Oldfusiondesigns/OFD_Flycore_Angled_Talon/Turbine_Open/Turbine_Mando.PNG

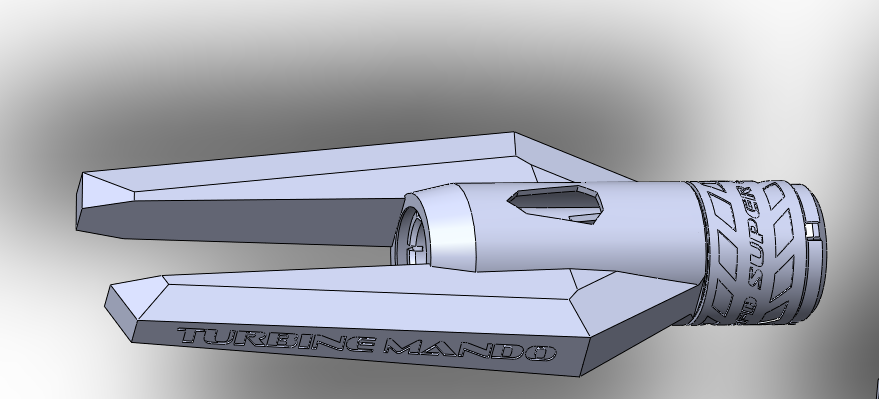
Turbine_Open/Turbine_Mando.PNG
