Oldfusiondesigns/OFD_Flycore_Angled_Talon/README.md

- 👋 Hi, It's Adam - aka OFD (OldFusionDesigns)!
- Please enjoy these files - the Flycore project, an open source Flywheel core for designing new and exciting blasters, as well as open source shroud geometry for my turbine scar!
