Oldfusiondesigns/OFD_Flycore_Angled_Talon/OFD_Flycore_Angled_V1/README.md

**What is Flycore?**

· Flycore is a 90% complete blaster awaiting your
new shell, design, or integration! I’ve done all
the work on flywheel spacing, pusher
mechanisms, and even a complete magwell with
detent or release!

· The goal of Flycore is to allow designers new
and old to focus on creating exciting new
designs with a proven flywheel core that’s
simple to build and has compact geometry to
integrate

**Details**

· Compatible with ANY Flywheel (From FTW to
Banned Blasters)

· Compatible with BOTH Angled and Slim Angled
Talons (Nightingale mags) with the same mag
release/detent

· Takes N20 Pushers (ROF from 300rpm/5dps up
to 3000rpm/50dps)

· Rear pusher position switch for controllable rate
of fire (wiring similar to 3 switch rapidstrike)

· Compatible with any 130 profile motor (can fit
132, 180s)

· Experimental topload capability

· Full steps provided to create your own new and
exciting blasters!

**Licensing and
Production**

· Flycore is license under CC-BY-SA-NC

· You have permission to print as many as you
like for yourself, and remix the files in any way
you like, but you CANNOT sell files or prints
without my permission or coming to an
agreement.

· If you wish to sell, please contact me so we can
arrange a licensing fee for a small percentage of
sale price

**Hardware List**

(2) 130 motors

(1) N20 Pusher Motor of your choice! (300-
3000rpm)

(4) m2x5mm motor screws

(8) M3x6mm heat set inserts (longer ones may
not work)

(6) M2.6x12mm toy screws

(1) M2.6x10mm toy screw (Optional)

(1) Cherry DB2 style switch for pusher position
(Optional)

(1) Spring 20mm in length less than 7mm in
diameter for mag release (Recommend
McMaster 9657K297 Trimmed to 20mm)
