Oldfusiondesigns/OFD_Flycore_Angled_Talon/OFD_Flycore_Angled_V1/OFD_Flycore_Angled_V1.pdf

## OFD

## FLYCORE

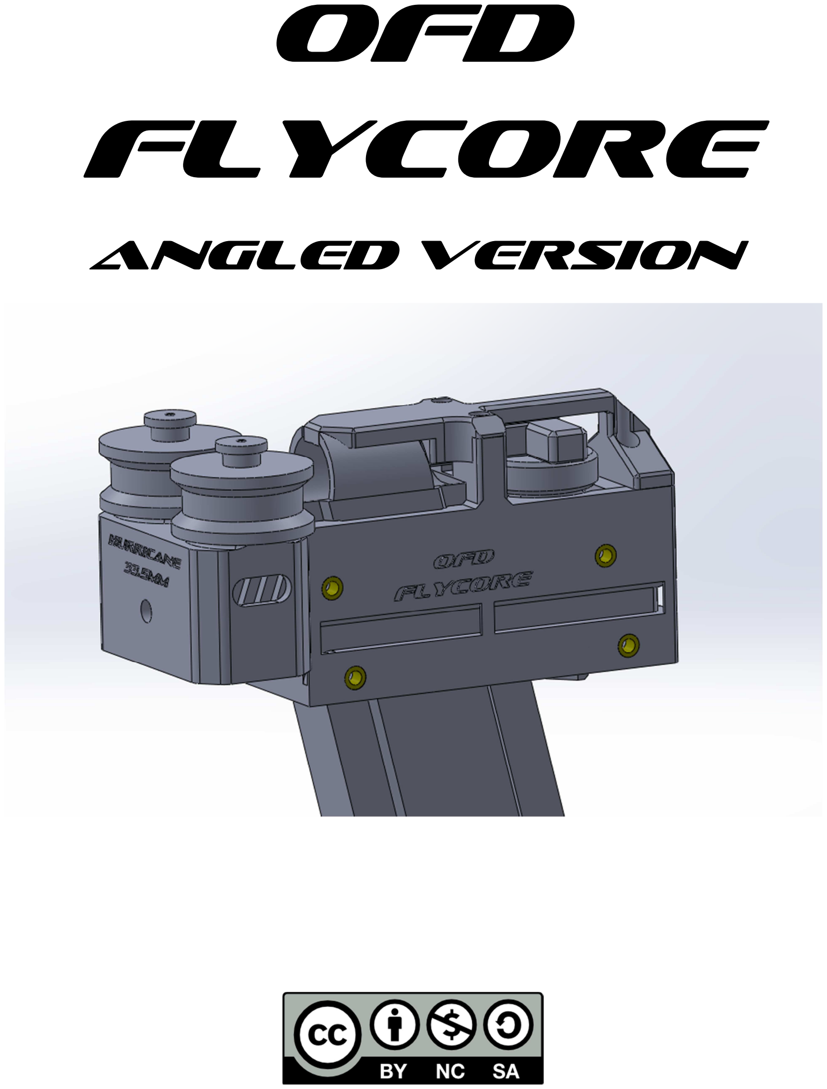
[picture p2: page 1]

Angled Version

What is Flycore?
- Flycore is a 90% complete blaster awaiting your new shell, design, or integration! I’ve done all the work on flywheel spacing, pusher mechanisms, and even a complete magwell with detent or release!
- The goal of Flycore is to allow designers new and old to focus on creating exciting new designs with a proven flywheel core that’s simple to build and has compact geometry to integrate

Details
- Compatible with ANY Flywheel (From FTW to Banned Blasters)
- Compatible with BOTH Angled and Slim Angled Talons (Nightingale mags) with the same mag release/detent
- Takes N20 Pushers (ROF from 300rpm/5dps up to 3000rpm/50dps)

- Rear pusher position switch for controllable rate of fire (wiring similar to 3 switch rapidstrike)
- Compatible with any 130 profile motor (can fit 132, 180s)
- Experimental topload capability
- Full steps provided to create your own new and exciting blasters!

Licensing and
Production
- Flycore is license under CC-BY-SA-NC
- You have permission to print as many as you like for yourself, and remix the files in any way you like, but you CANNOT sell files or prints without my permission or coming to an agreement.
- If you wish to sell, please contact me so we can arrange a licensing fee for a small percentage of sale price

Hardware List
(2) 130 motors
(1) N20 Pusher Motor of your choice! (300-3000rpm)
(4) m2x5mm motor screws
(8) M3x6mm heat set inserts (longer ones may not work)
(6) M2.6x12mm toy screws
(1) M2.6x10mm toy screw (Optional)
(1) Cherry DB2 style switch for pusher position (Optional)
(1) Spring 20mm in length less than 7mm in diameter for mag release (Recommend McMaster 9657K297 Trimmed to 20mm)

Print Orientation
- Supported Pieces (from buildplate): Core, Pusher
- Recommended Print settings (ALL): at least 3 perimeters, 15% infill, PETG Core if you’re using motors that get hot. Brim optional.

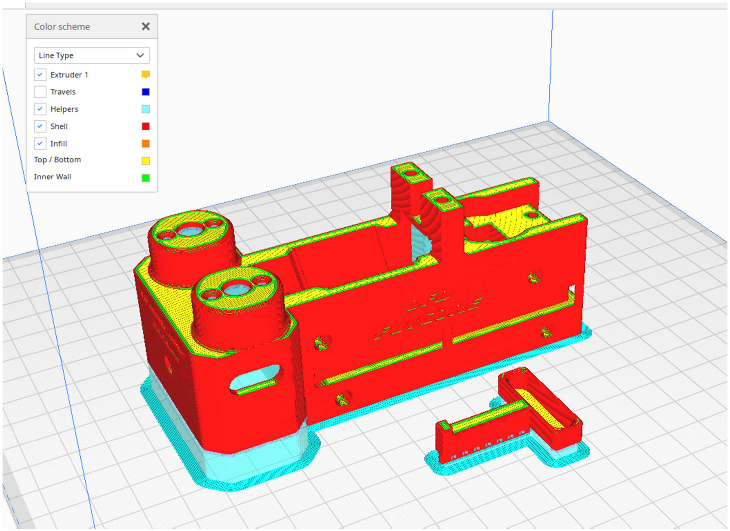
[picture p3: figure]

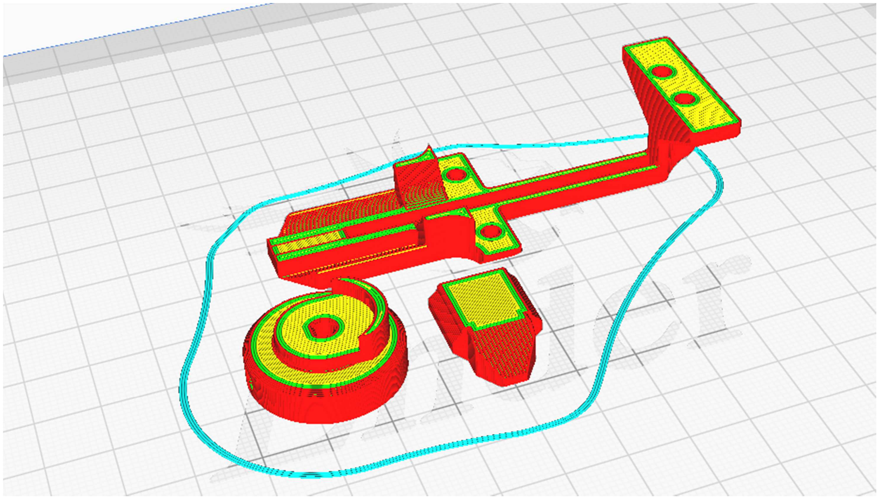
[picture p4: figure]

Assembly
Step 1: Install heatsets
TIP: Trim off any flashing inside and outside the core to prevent installation issues

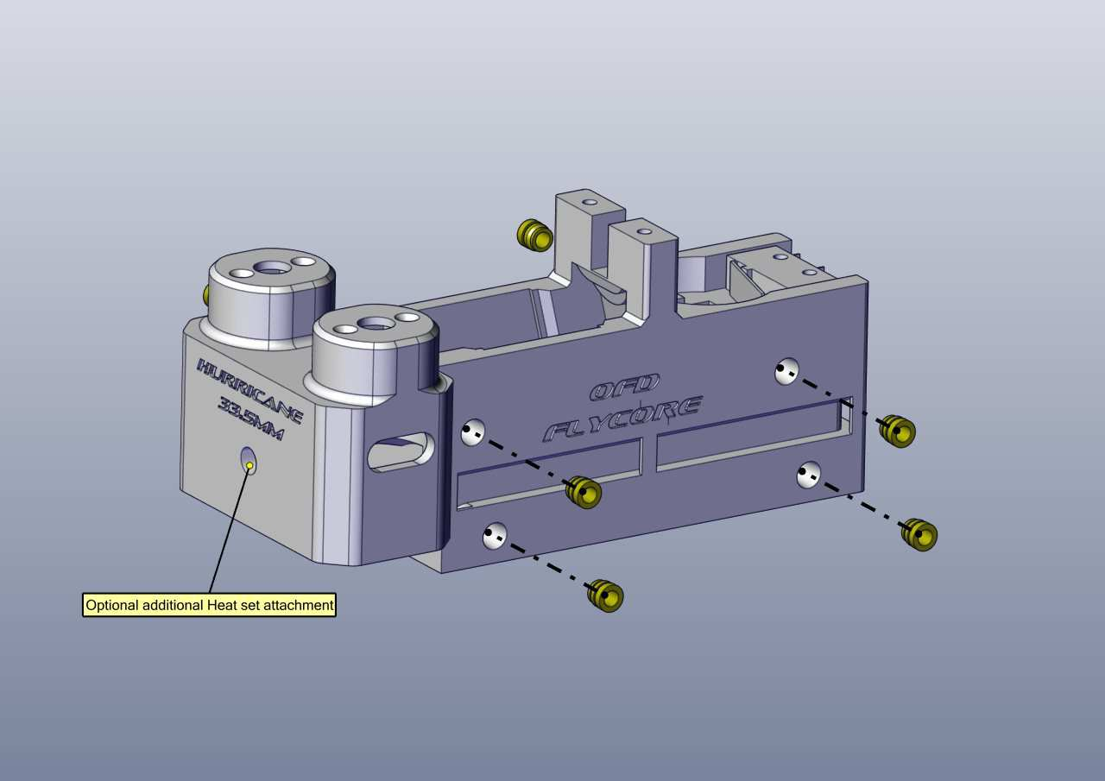
[picture p5: figure]

Step 2: Install N20

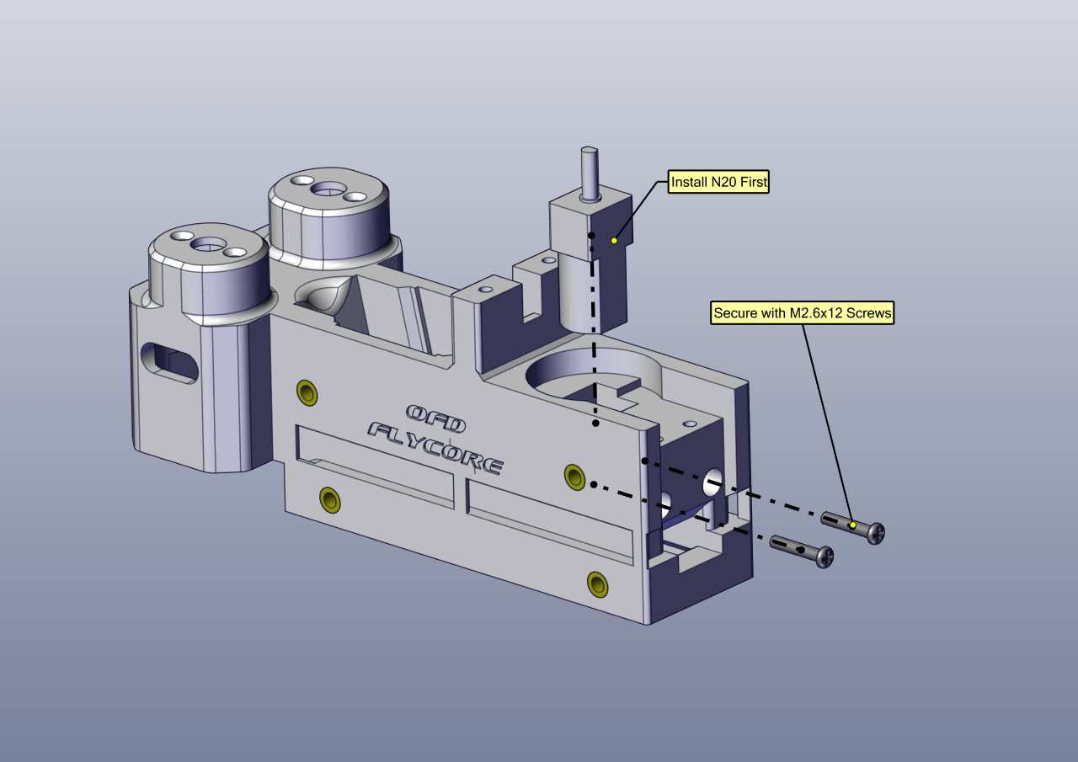
[picture p6: figure]

Step 3: Install Pusher Wheel

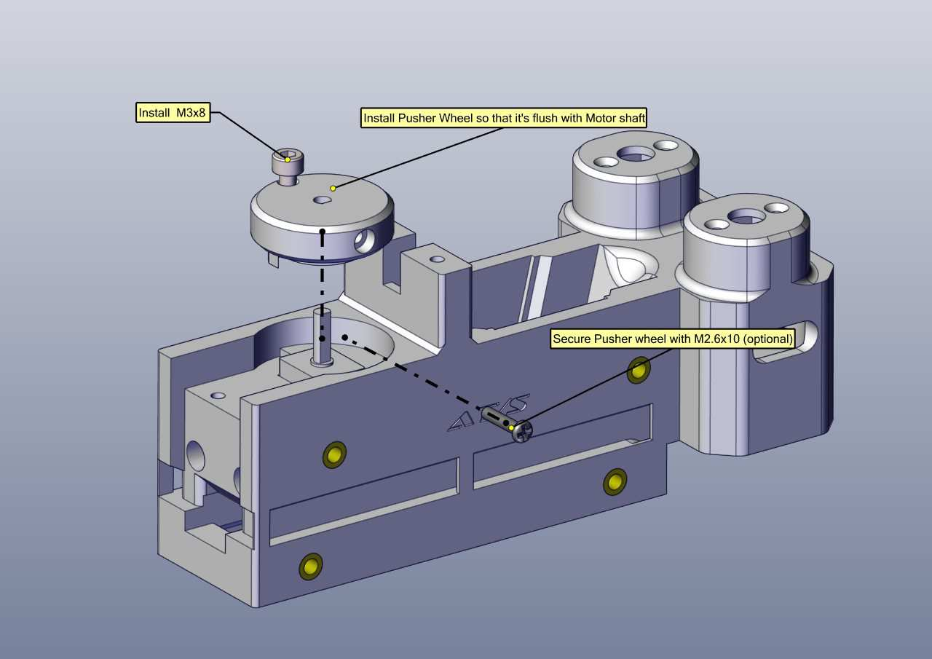
[picture p7: figure]

Step 4: Pusher Assembly Installation

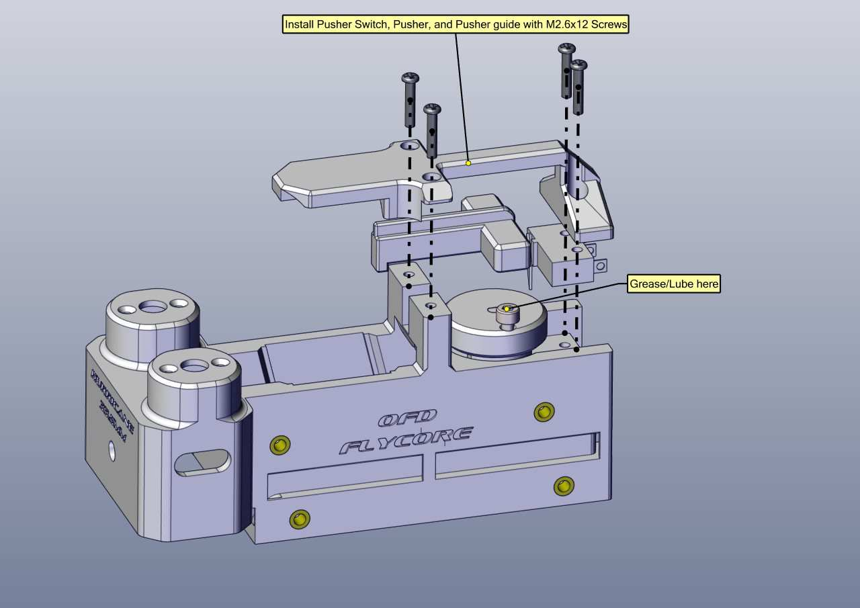
[picture p8: figure]

Step 5: Mag Release Installation

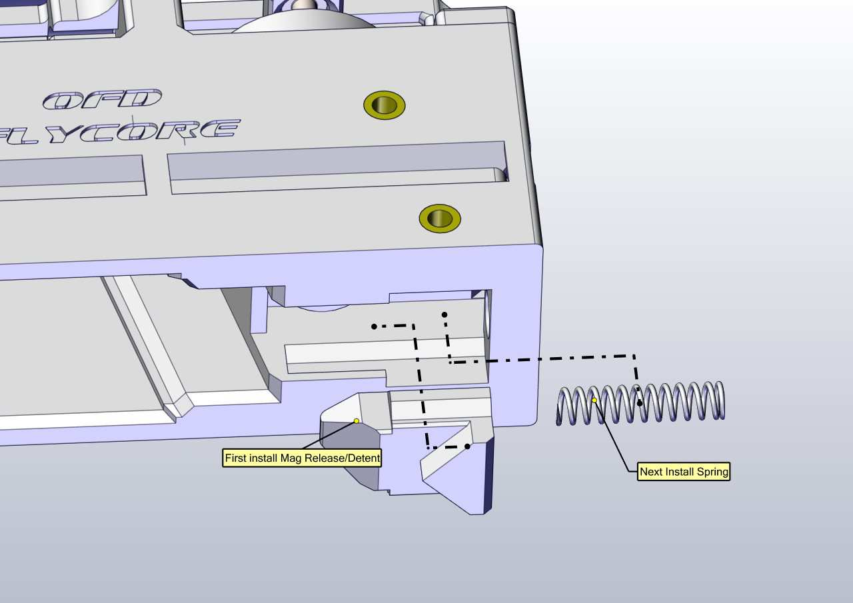
[picture p9: figure]

Step 6: Motor and Flywheel Installation

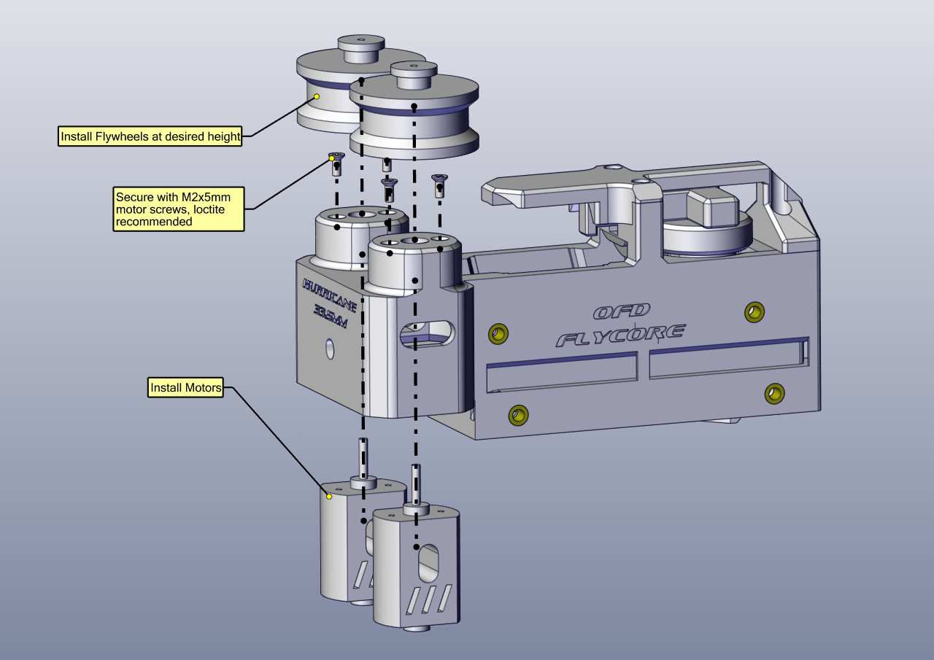
[picture p10: figure]

FAQ
- My N20 doesn’t seem like it’s activating the pusher switch!
a)If this is the case, bend the N20 switch arm slightly outward until it activates the switch when the pusher is fully back
- My 2000 or 3000 rpm pusher is running away, or won’t brake when I release the trigger!
a)In my testing these motors don’t have enough torque to overcome their own inertia and brake within a cycle, so if you want to run this high ROF, I’d recommend not worrying about including a pusher switch.
- My slim angled talons aren’t feeding right!
a)In our testing, slim angled talons can be picky about darts and magazine cleanliness, especially at higher rates of fire, so YMMV!
- I have more questions, or my questions aren’t listed here!
a)No worries! Feel free to reach out to me on Etsy, or my discord: ag04#6231
