Oldfusiondesigns/OFD_Flycore_Angled_Talon/Turbine_Open/Full_Length_Pic.PNG

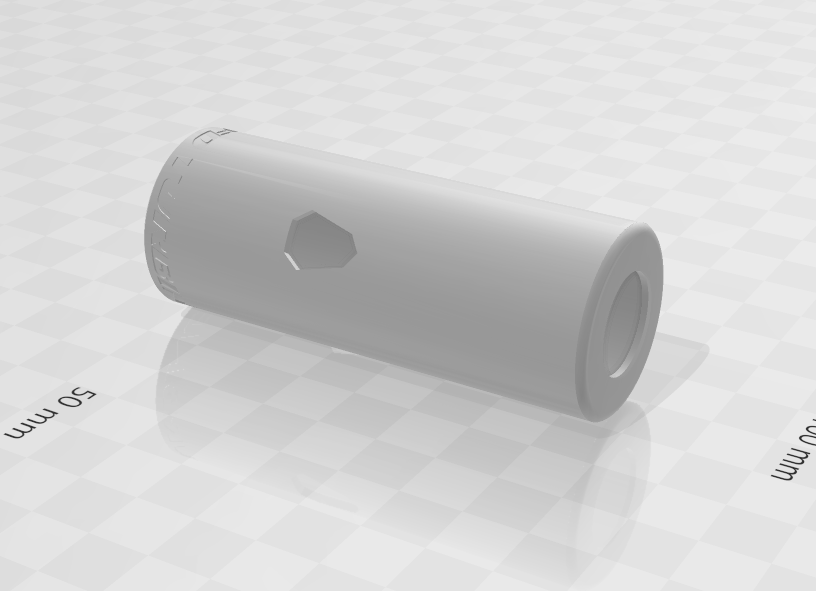
Turbine_Open/Full_Length_Pic.PNG
