Oldfusiondesigns/OFD_Flycore_Angled_Talon/Turbine_Open/Mini_Pic.PNG

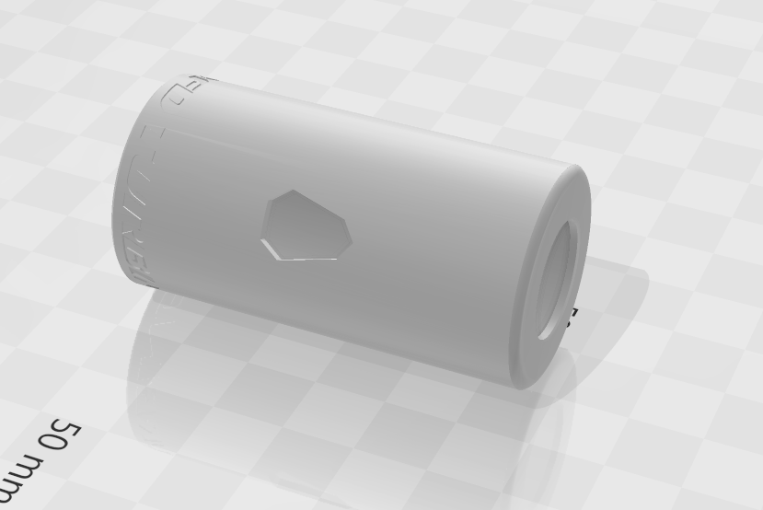
Turbine_Open/Mini_Pic.PNG
