Oldfusiondesigns/OFD_Flycore_Angled_Talon/Meowser_Quik_Flycore_Hardware_List_V1.1.xlsx

Sheet: Revision tracking
Changelog
Revision | Date | Changes
V1.0 | 2022-10-14 | Initial Release
V1.1 | 2023-03-01 | BOM corrections, additions, verification

Sheet: Flycore Angled+Straight
FLYCORE ANGLED/STRAIGHT BOM (NO BLASTER)
Priority | Category | Part | Qty | Description
REQUIRED | HARDWARE | M3 Heatsets (5-5.4mm Dia, <6.5mm length) | 9 | (8) Quik (9) Meowser
 |  | M3x8mm Socket Head Cap Screw | 1 | N20 Pusher wheel set screw
 |  | M2x4-5mm motor screws | 4 | Motor screws
 |  | M2.6x10mm toy screws | 1 | Pusher wheel set screw
 |  | M2.6x12mm toy screws | 6 | (4) pusher guide (2) optional N20 motor set screws
 |  | Mcmaster 9657k297 Trimmed to 20-22mm OR alt part 9657K282(pending update) | 1 | Mag release spring
 | ELECTRONICS | 130-180 motors | 2 | 130 Motors for best vent fitment
 |  | Cherry DB2 style switch with lever | 1 | Pusher postion switch
 |  | N20 Pusher Motor | 1 | Recommend under 1000 rpm and under for live center and 2000 rpm for highest reliable ROF

Sheet: Meowser
MEOWSER BOM (NO FLYCORE)
Priority | Category | Part | Qty | Description
REQUIRED | HARDWARE | M2x4-5mm motor screws | 4 | Rear sight, Volt meter
 |  | M2.6x12mm Toy Screws | 4 | Muzzle on square barrel, Mag release, Switch pack
 |  | M3x8mm Socket Head Cap Screws | 14 | (9) body, (3) barrel
 |  | M3x6-8mm Button Head Screw | 1 | LH Grip
 |  | M3x8-10mm Battery door screw | 1 | Battery Door
 |  | M3 Heatsets (5-5.4mm Dia, <6.5mm length) | 5 | (3) Barrel (2) Grip/Batt door
 |  | Mcmaster 9657k297 Trimmed to 20-22mm OR alt part 9657K282(pending update) | 1 | Trigger Spring
 | ELECTRONICS | 21A Omron style switch without Lever | 1 | Rev switch
 |  | Cherry DB2 style switch without lever | 1 | Pusher switch
 |  | 22 Ga wire | 1 | Pusher, Trigger Switch
 |  | 18 Ga wire | 1 | Motors, Rev Switch, Battery
 |  | XT30 connector | 1 | Battery Connector
 |  | Heatshrink | 1 | Heatshrink for xt30
OPTIONAL | HARDWARE | M3x12 Socket Head Cap Screws | 4 | Fidlock Mounts
 |  | .078"/2mm Fiber optic | 1
 |  | Fidlock M | 2 | approx 50mm total for sights
 | ELECTRONICS | .28" Battery Voltage meter | 1
OPTIONAL DL-44 Kit | HARDWARE | M3x12 Socket Head Cap Screws | 4 | Scope mounting plate
 |  | M3 Heatsets | 2 | Scope mount assembly
 |  | M3x8-10mm thumb screws OR M3x8 Socket Head Cap Screws | 2 | Scope mount side
 |  | M3x8 Socket Head Cap Screws | 6 | (4) Scope rings (2) upper mount
OPTIONAL Tactical Kit | HARDWARE | M2x4-5mm motor screws | 1 | Printed RMR reticle set screw
 |  | M3x8 Socket Head Cap Screws | 2 | Printed RMR

Sheet: Flycore+Meowser
MEOWSER + FLYCORE STRAIGHT BOM
Priority | Category | Part | Qty | Description
REQUIRED | HARDWARE | M2x4-5mm motor screws | 8 | (2) Rear sight, (2)Volt meter/blank plate (4) Motors
 |  | M2.6x10mm toy screws | 1 | N20 pusher wheel set screw
 |  | M2.6x12mm toy Screws | 10 | (2) Muzzle on square barrel, (4) Flycore pusher guide, (2) N20 Set screws, (1) Mag release (1) Switch pack
 |  | M3x8mm Socket Head Cap Screws | 13 | (9) body, (3) barrel (1) Flycore Pusher Wheel
 |  | M3x6-8mm Button Head Screw | 1 | RH Grip
 |  | M3x8-10mm Battery door thumb screw | 1 | Battery Door
 |  | M3 Heatsets (5-5.4mm Dia, <6.5mm length) | 14 | (9) Flycore Straight (3) Barrel (2) Grip/Batt door
 |  | Mcmaster 9657k297 Trimmed to 20-22mm OR alt part 9657K282(pending update) | 2 | Trigger Spring, Flycore mag release
 | ELECTRONICS | 130-180 motors | 2 | 130 Motors for best vent fitment
 |  | N20 Pusher Motor | 1 | Recommend 1000 rpm and under for live center and 2000 rpm for highest reliable ROF (2k untested on high ROF Tachis)
 |  | 21A Omron style switch without Lever | 1 | Rev switch
 |  | Cherry DB2 style switch without lever | 1 | Pusher switch
 |  | Cherry DB2 style switch with lever | 1 | Pusher postion switch
 |  | 22 Ga wire | 1 | Pusher, Trigger Switch
 |  | 18 Ga wire | 1 | Motors, Rev Switch, Battery
 |  | XT30 connector | 1 | Battery Connector
 |  | Heatshrink | 1 | Heatshrink for xt30
OPTIONAL | HARDWARE | M3x12 Socket Head Cap Screws | 4 | Fidlock Mounts
 |  | .078"/2mm Fiber optic | 1 | approx 50mm total for sights
 |  | Fidlock M | 2
 | ELECTRONICS | .28" Battery Voltage meter | 1
OPTIONAL DL-44 Kit | HARDWARE | M3x12 Socket Head Cap Screws | 4 | Scope mounting plate
 |  | M3 Heatsets | 2 | Scope mount assembly
 |  | M3x8-10mm thumb screws OR M3x8 Socket Head Cap Screws | 2 | Scope mount side
 |  | M3x8 Socket Head Cap Screws | 6 | (4) Scope rings (2) upper mount
OPTIONAL Tactical Kit | HARDWARE | M2x4-5 motor screw | 1 | Printed RMR reticle set screw
 |  | M3x8 Socket Head Cap Screws | 2 | Printed RMR

Sheet: Quik
QUIK BOM (NO FLYCORE)
Priority | CATEGORY | Part | Qty | Description
REQUIRED | HARDWARE | M2x4-5mm motor screws | 2 | Rear sight
 |  | M2.6x12mm Toy Screws | 1 | switch plate
 |  | M3x8mm Socket Head Cap Screws | 9 | (8) body, (1) switch plate
 |  | M3x8-10mm Battery door screw | 1 | Battery Door
 |  | M3 Heatsets (5-5.4mm Dia, <6.5mm length) | 2 | (1) switch plate (1) batt door
 |  | Mcmaster 9657k297 Trimmed to 20-22mm | 1 | Trigger Spring
 | ELECTRONICS | 21A Omron style switch without Lever | 1 | Rev switch
 |  | Cherry DB2 style switch with lever | 1 | Pusher switch
 |  | 22 Ga wire | 1 | Pusher, Trigger Switch
 |  | 18 Ga wire | 1 | Motors, Rev Switch, Battery
 |  | XT30 connector | 1 | Battery Connector
 |  | Heatshrink | 1 | Heatshrink for xt30
OPTIONAL | HARDWARE | M3x12 Socket Head Cap Screws | 4 | Fidlock Mounts
 |  | Fidlock M | 2
 | ELECTRONICS | .28" Battery Voltage meter | 1

Sheet: Flycore+Quik
QUIK + FLYCORE ANGLED BOM
Priority | Category | Part | Qty | Description
REQUIRED | HARDWARE | M2x4-5mm motor screws | 6 | (2) Rear sight, (4) Motor screws
 |  | M2.6x10mm toy screws | 1 | N20 pusher wheel set screw
 |  | M2.6x12mm Toy Screws | 1 | (4) pusher guide (2) optional n20 set screws (1) switch plate
 |  | M3x8mm Socket Head Cap Screws | 10 | (8) body, (1) switch plate (1) Flycore pusher wheel
 |  | M3x8-10mm battery door thumb screw | 1 | Battery Door
 |  | M3 Heatsets (5-5.4mm Dia, <6.5mm length) | 10 | (1) switch plate (1) batt door (8) Flycore Angled
 |  | Mcmaster 9657k297 Trimmed to 20-22mm OR alt part 9657K282(pending update) | 2 | (1) Trigger spring (1) Mag release spring
 | ELECTRONICS | 130-180 motors | 2 | 130 Motors for best vent fitment
 |  | N20 Pusher Motor | 1 | Recommend 1000 rpm and under for live center and 2000 rpm max for highest reliable ROF
 |  | 21A Omron style switch without Lever | 1 | Rev switch
 |  | Cherry DB2 style switch with lever | 2 | (1) Pusher switch (1) Trigger switch
 |  | 22 Ga wire | 1 | Pusher, Trigger Switch
 |  | 18 Ga wire | 1 | Motors, Rev Switch, Battery
 |  | XT30 connector | 1 | Battery Connector
 |  | Heatshrink | 1 | Heatshrink for xt30
OPTIONAL | HARDWARE | M3x12 Socket Head Cap Screws | 4 | Fidlock Mounts
 |  | Fidlock M | 2
 | ELECTRONICS | .28" Battery Voltage meter | 1
