Oldfusiondesigns/OFD_Flycore_Angled_Talon/Quik_Freebies/Fidlock Mounts/Fidlock_M_LH_FULL_V1.STL

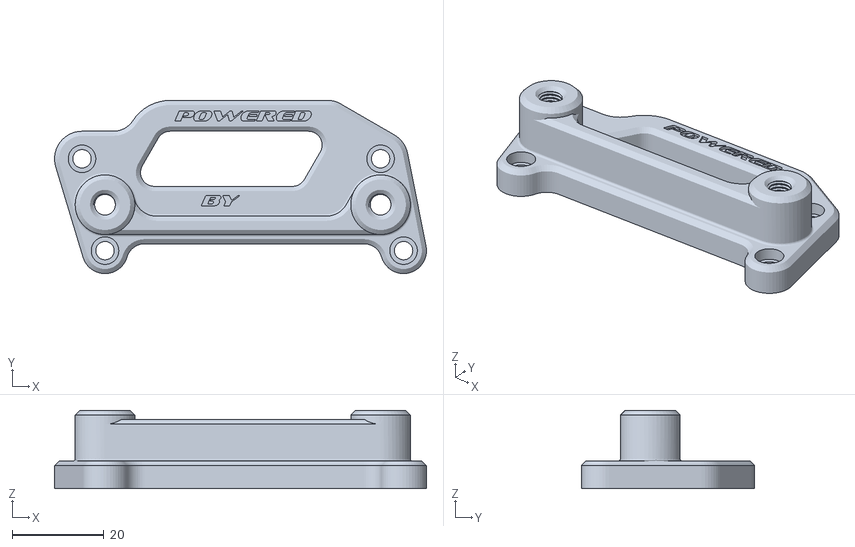
[picture p13: CAD file, 2022-12-12]
Quik_Freebies/Fidlock Mounts/Fidlock_M_LH_FULL_V1.STL
81.0 x 37.7 x 17.0
