Oldfusiondesigns/OFD_Flycore_Angled_Talon/OFD_Flycore_Angled_V1/STEPs/OFD_FLYCORE_ANGLED_FULL_42MM_MSB_V1.STEP

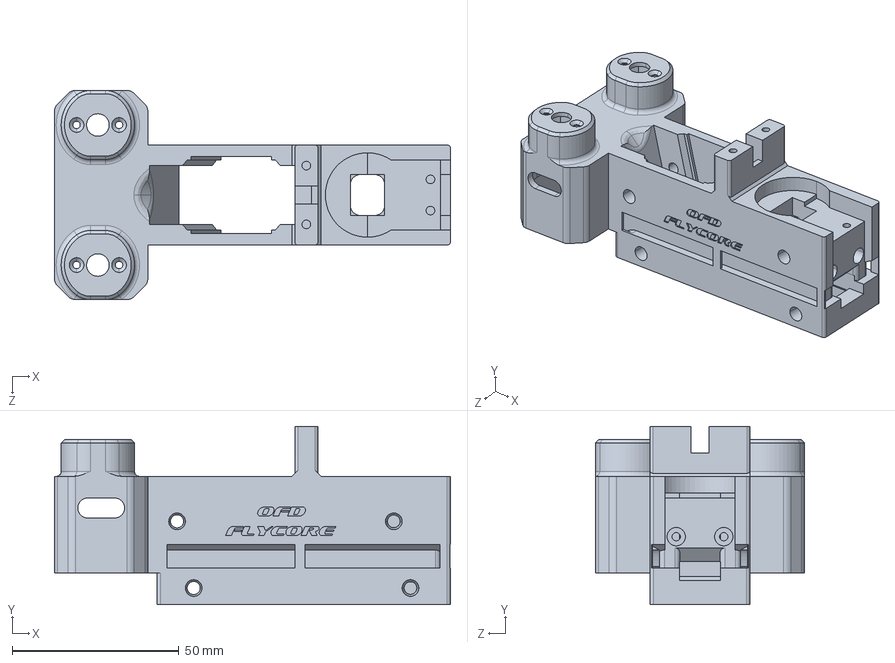
[picture p14: CAD file, 2022-07-21]
OFD_Flycore_Angled_V1/STEPs/OFD_FLYCORE_ANGLED_FULL_42MM_MSB_V1.STEP
118.8 x 53.5 x 62.7 mm
