Oldfusiondesigns/OFD_Flycore_Angled_Talon/OFD_Flycore_Angled_V1/STEPs/OFD_FLYCORE_ANGLED_TRACEUR_25MM_V1.step

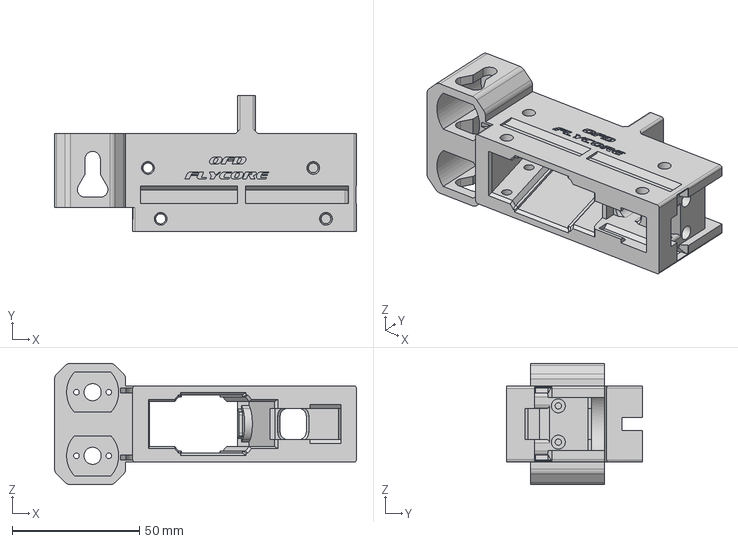
[picture p16: CAD file, 2024-01-23]
OFD_Flycore_Angled_V1/STEPs/OFD_FLYCORE_ANGLED_TRACEUR_25MM_V1.step
118.8 x 53.5 x 47.7 mm
