Oldfusiondesigns/OFD_Flycore_Angled_Talon/Q2 Freebies/Q2_Batt_Door_Button_V1.STL

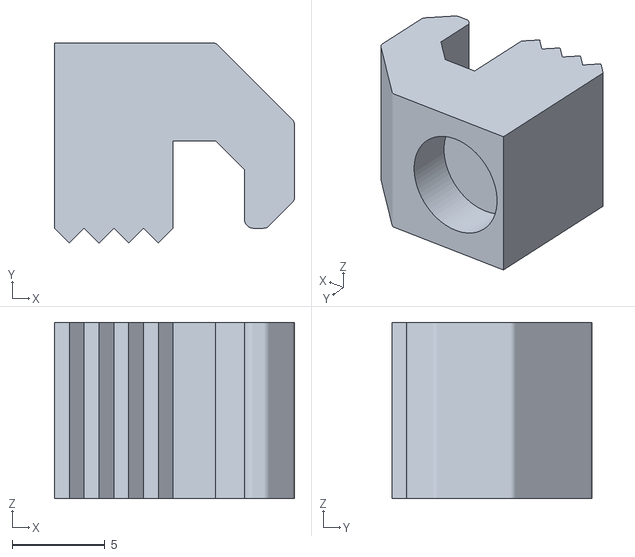
[picture p17: CAD file, 2024-07-10]
Q2 Freebies/Q2_Batt_Door_Button_V1.STL
13.0 x 10.8 x 9.50
