Oldfusiondesigns/OFD_Flycore_Angled_Talon/Quik_Freebies/Volt_Meter_BLANKING_PLATE.STL

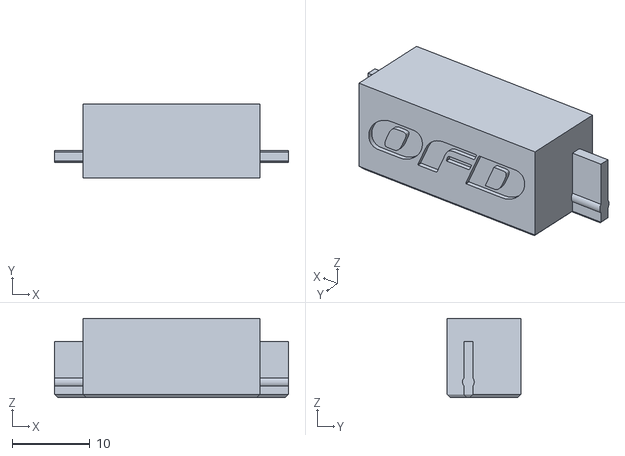
[picture p18: CAD file, 2022-08-31]
Quik_Freebies/Volt_Meter_BLANKING_PLATE.STL
30.0 x 9.50 x 10.2
