Oldfusiondesigns/OFD_Flycore_Angled_Talon/Turbine_Open/Turbine_Shroud_v2.STEP

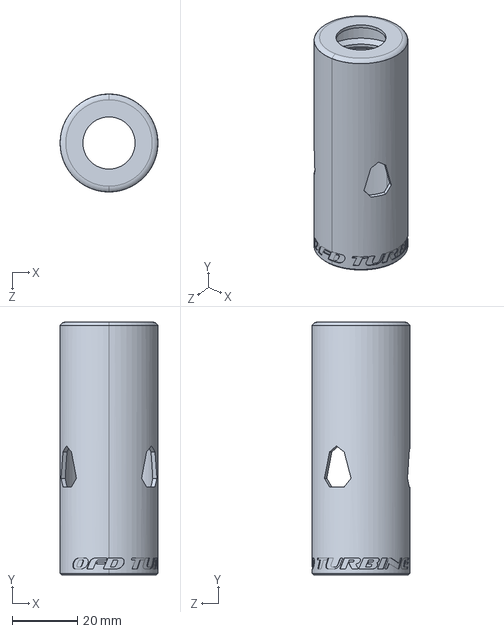
[picture p19: CAD file, 2022-05-17]
Turbine_Open/Turbine_Shroud_v2.STEP
30.0 x 77.5 x 30.0 mm
