Oldfusiondesigns/OFD_Flycore_Angled_Talon/OFD_Flycore_Angled_V1/STEPs/OFD_FLYCORE_ANGLED_SPARTAN_23.5MM_V2.STEP

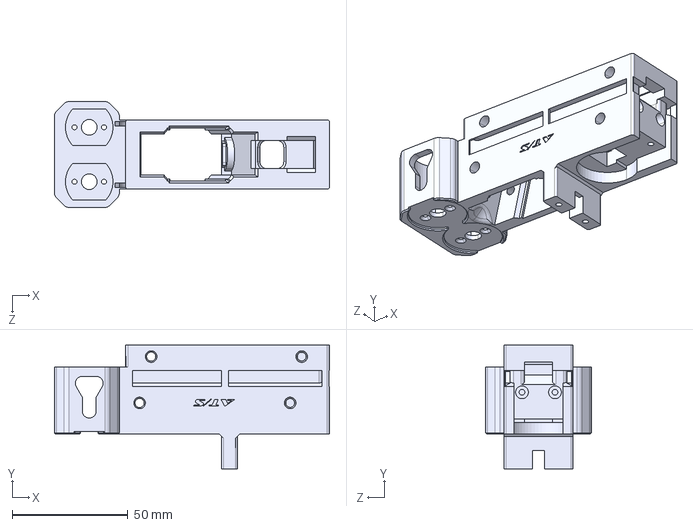
[picture p21: CAD file, 2023-12-21]
OFD_Flycore_Angled_V1/STEPs/OFD_FLYCORE_ANGLED_SPARTAN_23.5MM_V2.STEP
118.8 x 53.5 x 45.7 mm
