Oldfusiondesigns/OFD_Flycore_Angled_Talon/Quik_Freebies/OFD_Angled_Talon_Stand_V1.STEP

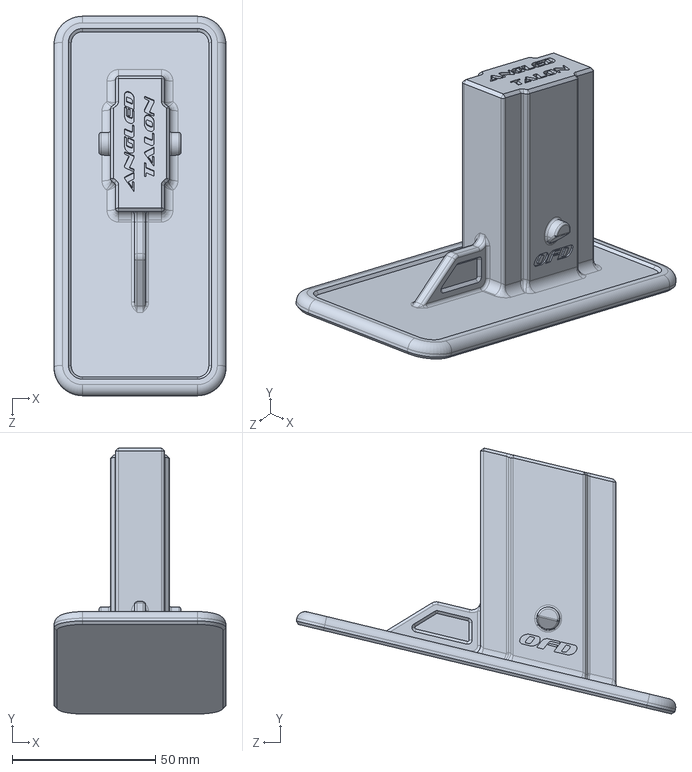
[picture p22: CAD file, 2022-08-12]
Quik_Freebies/OFD_Angled_Talon_Stand_V1.STEP
60.0 x 92.8 x 132.5 mm
