Oldfusiondesigns/OFD_Flycore_Angled_Talon/Turbine_Open/Turbine_Mini_Shroud_SciFi_Mando_V2.STEP

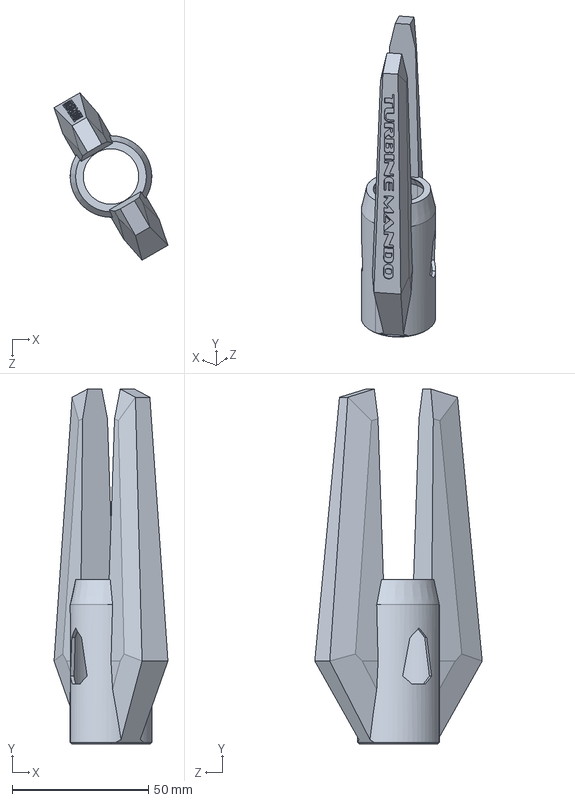
[picture p23: CAD file, 2022-05-17]
Turbine_Open/Turbine_Mini_Shroud_SciFi_Mando_V2.STEP
41.9 x 130.5 x 61.6 mm
