Oldfusiondesigns/OFD_Flycore_Angled_Talon/Quik_Freebies/Fidlock Mounts/Fidlock_M_RH_FTW_V1.stl

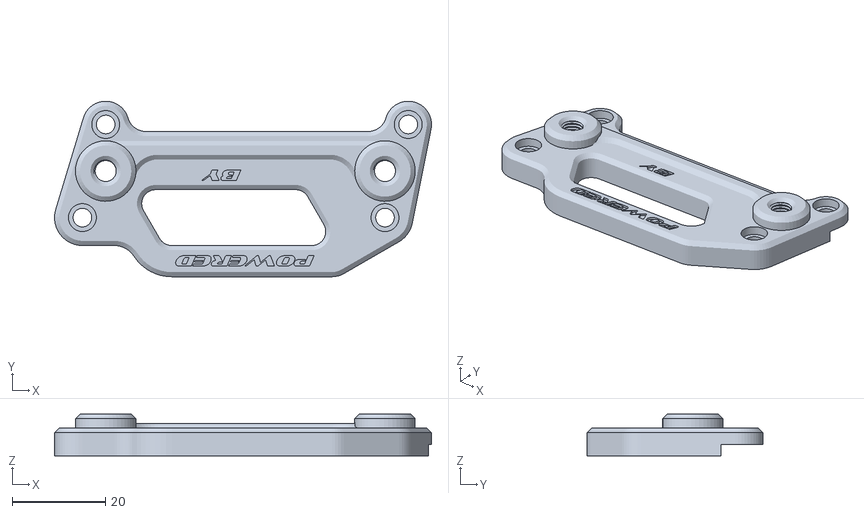
[picture p25: CAD file, 2022-12-12]
Quik_Freebies/Fidlock Mounts/Fidlock_M_RH_FTW_V1.stl
81.0 x 37.7 x 9.00
