Oldfusiondesigns/OFD_Flycore_Angled_Talon/Turbine_Open/Turbine_Mini_Shroud_v4.STEP

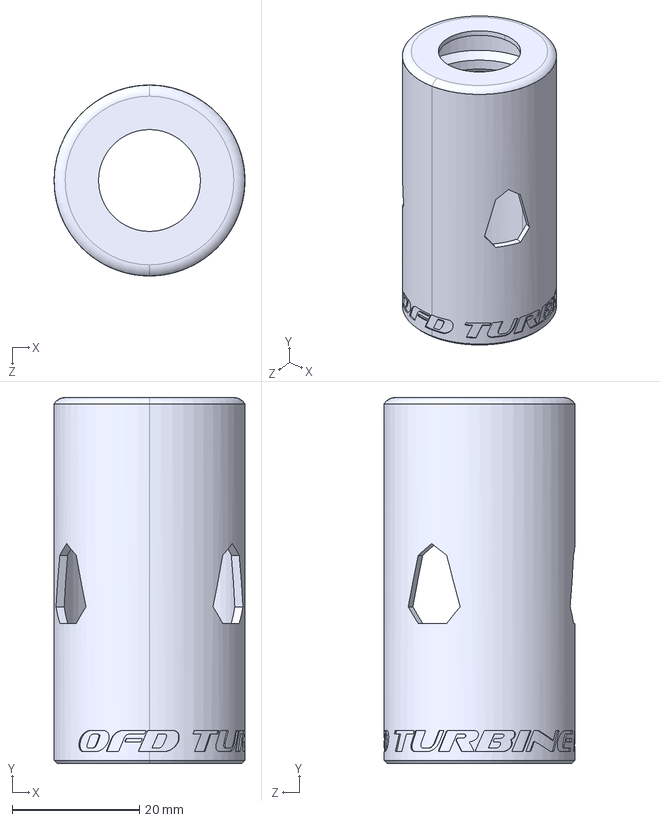
[picture p26: CAD file, 2022-05-17]
Turbine_Open/Turbine_Mini_Shroud_v4.STEP
30.0 x 57.5 x 30.0 mm
