Oldfusiondesigns/OFD_Flycore_Angled_Talon/OFD_Flycore_Angled_V1/Flywheel_Spacers/OFD_Flywheel_Spacer_2.5mm_V1.STL

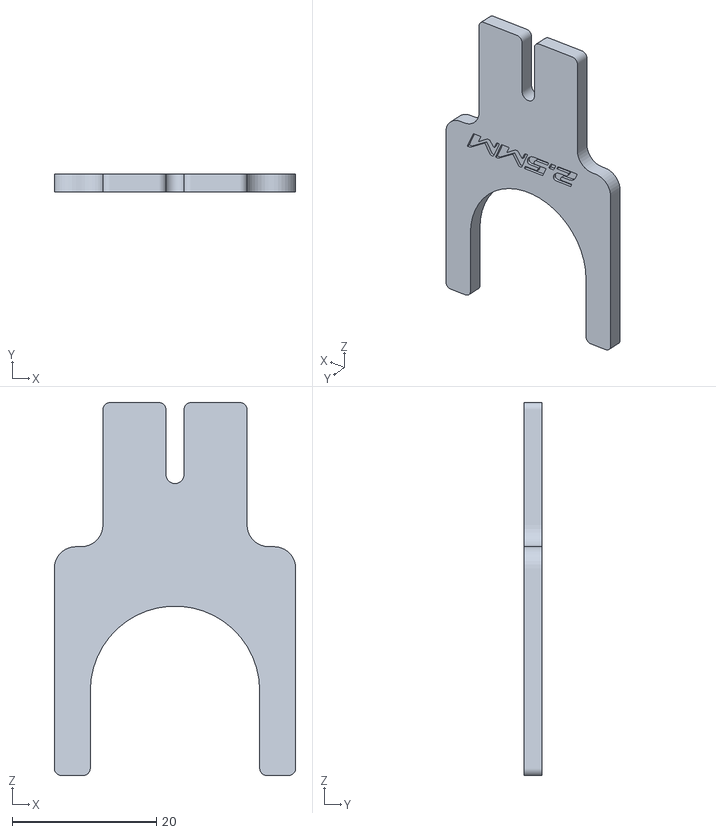
[picture p27: CAD file, 2022-10-17]
OFD_Flycore_Angled_V1/Flywheel_Spacers/OFD_Flywheel_Spacer_2.5mm_V1.STL
33.5 x 2.50 x 51.8
