Oldfusiondesigns/OFD_Flycore_Angled_Talon/OFD_Flycore_Angled_V1/Flywheel_Spacers/OFD_Flywheel_Spacer_1mm_V1.STL

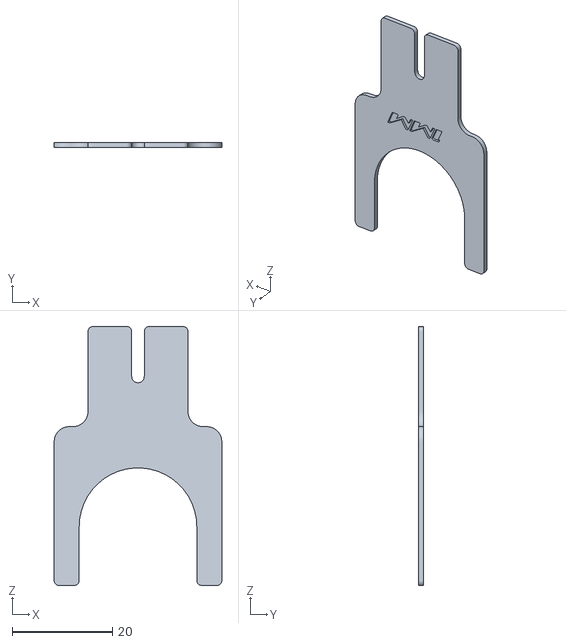
[picture p29: CAD file, 2022-10-17]
OFD_Flycore_Angled_V1/Flywheel_Spacers/OFD_Flywheel_Spacer_1mm_V1.STL
33.5 x 1.00 x 51.8
