Oldfusiondesigns/OFD_Flycore_Angled_Talon/OFD_Flycore_Angled_V1/STEPs/Pusher_Wheel++_V1.STEP

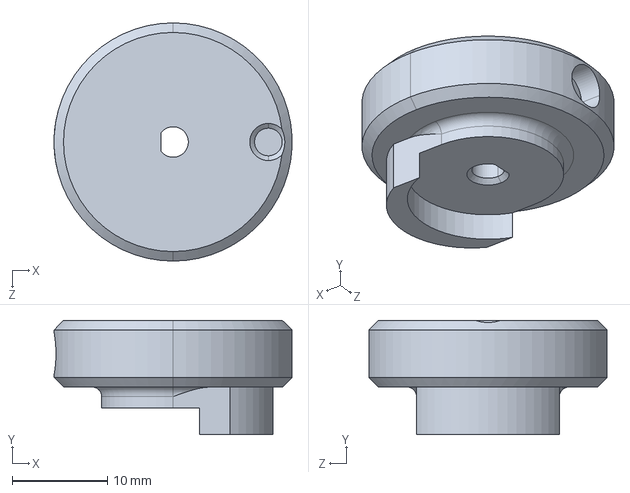
[picture p31: CAD file, 2022-08-30]
OFD_Flycore_Angled_V1/STEPs/Pusher_Wheel++_V1.STEP
25.0 x 12.0 x 25.0 mm
