Oldfusiondesigns/OFD_Flycore_Angled_Talon/OFD_Flycore_Angled_V1/STEPs/OFD_FLYCORE_ANGLED_HURRICANE_32.5MM_V1.STEP

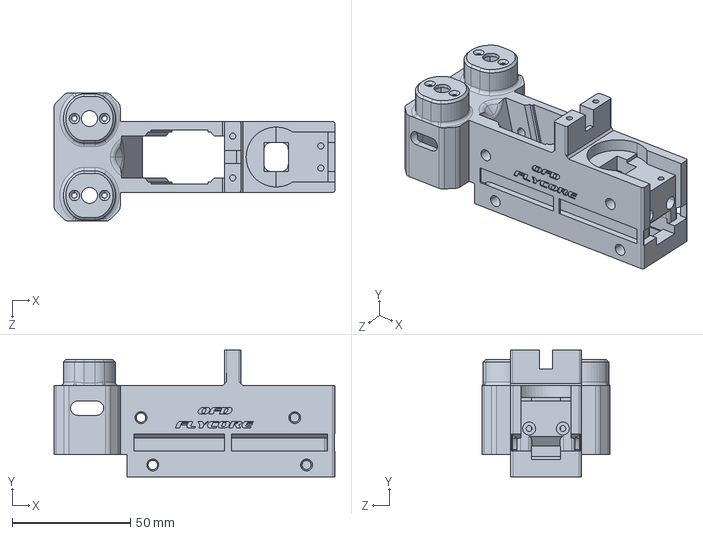
[picture p33: CAD file, 2022-07-21]
OFD_Flycore_Angled_V1/STEPs/OFD_FLYCORE_ANGLED_HURRICANE_32.5MM_V1.STEP
118.8 x 53.5 x 54.2 mm
