Oldfusiondesigns/OFD_Flycore_Angled_Talon/OFD_Flycore_Angled_V1/STEPs/Pusher_Guide_V1.STEP

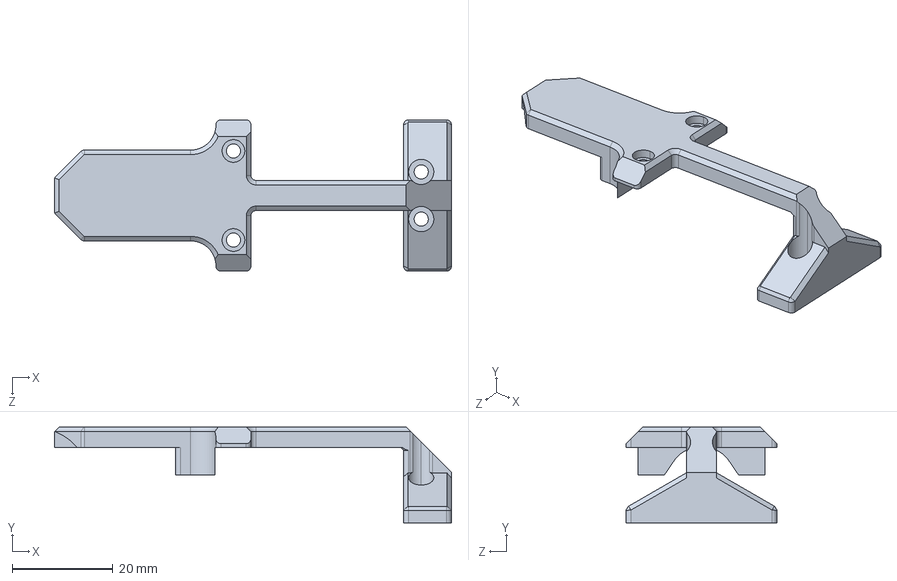
[picture p34: CAD file, 2022-07-21]
OFD_Flycore_Angled_V1/STEPs/Pusher_Guide_V1.STEP
78.7 x 19.0 x 30.0 mm
