Oldfusiondesigns/OFD_Flycore_Angled_Talon/OFD_Flycore_Angled_V1/STEPs/Mag_Detent_V1.STEP

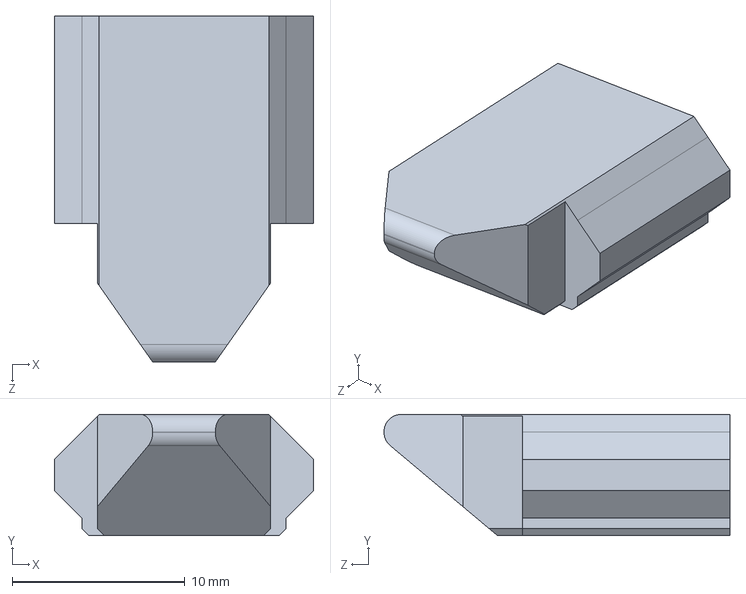
[picture p36: CAD file, 2022-07-21]
OFD_Flycore_Angled_V1/STEPs/Mag_Detent_V1.STEP
15.0 x 7.00 x 20.0 mm
