Oldfusiondesigns/OFD_Flycore_Angled_Talon/OFD_Flycore_Angled_V1/STEPs/Pusher_V1.STEP

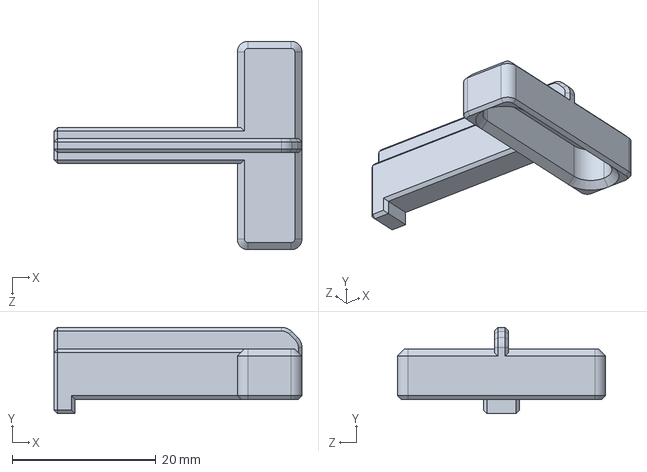
[picture p38: CAD file, 2022-07-21]
OFD_Flycore_Angled_V1/STEPs/Pusher_V1.STEP
34.5 x 12.0 x 29.0 mm
