Oldfusiondesigns/OFD_Flycore_Angled_Talon/(list of files, cad)

Other CAD files:
Quik_Freebies/Fidlock Mounts/Fidlock_M_RH_FULL_V1.stl
OFD_Flycore_Angled_V1/STEPs/OFD_FLYCORE_ANGLED_FULL_40MM_V1.STEP
OFD_Flycore_Angled_V1/STEPs/OFD_FLYCORE_ANGLED_FULL_41MM_V1.STEP
OFD_Flycore_Angled_V1/STEPs/OFD_FLYCORE_ANGLED_FULL_42MM_V1.STEP
OFD_Flycore_Angled_V1/STEPs/OFD_FLYCORE_ANGLED_FULL_43MM_MSB_V1.STEP
OFD_Flycore_Angled_V1/STEPs/OFD_FLYCORE_ANGLED_FULL_41MM_MSB_V1.STEP
OFD_Flycore_Angled_V1/STEPs/OFD_FLYCORE_ANGLED_FULL_40MM_MSB_V1.STEP
OFD_Flycore_Angled_V1/STEPs/OFD_FLYCORE_ANGLED_FULL_43MM_V1.STEP
OFD_Flycore_Angled_V1/STEPs/OFD_FLYCORE_ANGLED_NGALE_19.8MM_V1.STEP
OFD_Flycore_Angled_V1/STEPs/OFD_FLYCORE_ANGLED_NGALE_20MM_V1.STEP
OFD_Flycore_Angled_V1/STEPs/OFD_FLYCORE_ANGLED_NGALE_19.5MM_V1.STEP
Quik_Freebies/Fidlock Mounts/Fidlock_M_RH_HURR_V1.stl
Quik_Freebies/Fidlock Mounts/Fidlock_M_LH_FTW_V1.STL
OFD_Flycore_Angled_V1/STEPs/OFD_FLYCORE_ANGLED_HURRICANE_33.5MM_V1.STEP
OFD_Flycore_Angled_V1/STEPs/OFD_FLYCORE_ANGLED_FTW_23MM_V1.STEP
OFD_Flycore_Angled_V1/STEPs/OFD_FLYCORE_ANGLED_HURRICANE_33MM_V1.STEP
OFD_Flycore_Angled_V1/STEPs/OFD_FLYCORE_ANGLED_FTW_22MM_V1.STEP
OFD_Flycore_Angled_V1/STEPs/Pusher_Wheel+_V1.STEP
OFD_Flycore_Angled_V1/STEPs/Pusher_Wheel_V1.STEP
OFD_Flycore_Angled_V1/STLs/Mag_Detent_V1.STL
OFD_Flycore_Angled_V1/STLs/Mag_Release_V1.STL
OFD_Flycore_Angled_V1/STLs/OFD_FLYCORE_ANGLED_FTW_22MM_V1.STL
OFD_Flycore_Angled_V1/STLs/OFD_FLYCORE_ANGLED_FTW_23MM_V1.STL
OFD_Flycore_Angled_V1/STLs/OFD_FLYCORE_ANGLED_NGALE_19.5MM_V1.STL
OFD_Flycore_Angled_V1/STLs/OFD_FLYCORE_ANGLED_NGALE_19.8MM_V1.STL
OFD_Flycore_Angled_V1/STLs/OFD_FLYCORE_ANGLED_NGALE_20MM_V1.STL
OFD_Flycore_Angled_V1/STLs/OFD_FLYCORE_ANGLED_SPARTAN_23.5MM_V2.STL
OFD_Flycore_Angled_V1/STLs/OFD_FLYCORE_ANGLED_TRACEUR_25MM_V1.stl
OFD_Flycore_Angled_V1/STLs/Pusher_Guide_Top_Load_Experimental_V1.STL
OFD_Flycore_Angled_V1/STLs/Pusher_Guide_V1.STL
OFD_Flycore_Angled_V1/STLs/Pusher_V1.STL
OFD_Flycore_Angled_V1/STLs/Pusher_Wheel++_V1.STL
OFD_Flycore_Angled_V1/STLs/Pusher_Wheel+_V1.STL
OFD_Flycore_Angled_V1/STLs/Pusher_Wheel_V1.STL
Turbine_Open/Turbine_Mini_Shroud_SciFi_Mando_V2.STL
Turbine_Open/Turbine_Mini_Shroud_v4.STL
Turbine_Open/Turbine_Shroud_v2.STL
