Oldfusiondesigns/OFD_Flycore_Angled_Talon/Q2 Freebies/changelog.md

Changelog
V1.1 7/10/2024 - Added battery door button stl that was missing
