Oldfusiondesigns/OFD_Flycore_Angled_Talon/Quik_Freebies/Griptape_pattern_v1.pdf

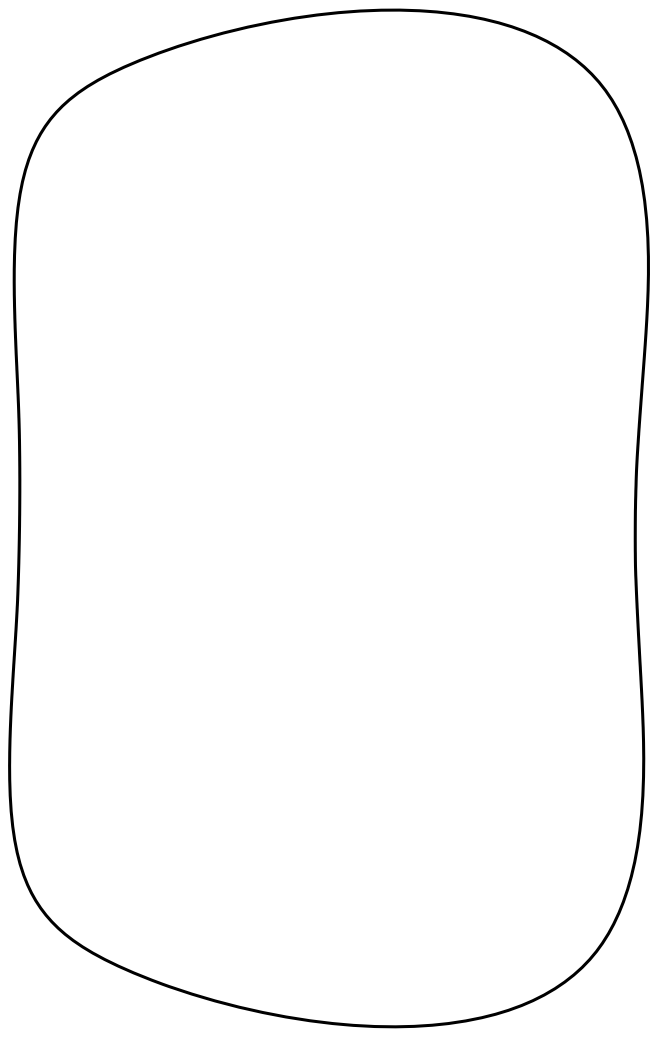
[picture p39: page 1]
