Oldfusiondesigns/OFD_Flycore_Angled_Talon/(commit log)

2022-07-21 Add files via upload
    Flycore Angled V1.0 Launch
    [Mag_Detent_V1.STEP, Mag_Detent_V1.STL, Mag_Release_V1.STEP, Mag_Release_V1.STL, OFD_FLYCORE_ANGLED_FTW_22MM_V1.STEP, OFD_FLYCORE_ANGLED_FTW_22MM_V1.STL, OFD_FLYCORE_ANGLED_FTW_23MM_V1.STEP, OFD_FLYCORE_ANGLED_FTW_23MM_V1.STL]
2022-08-07 Add files via upload
    Turbine Open - create your own shrouds for OFD Turbine Scar System!
    [Turbine_Mini_Shroud_SciFi_Mando_V2.STEP, Turbine_Mini_Shroud_SciFi_Mando_V2.STL, Turbine_Mini_Shroud_v4.STEP, Turbine_Mini_Shroud_v4.STL, Turbine_Shroud_v2.STEP, Turbine_Shroud_v2.STL]
2022-08-08 Add files via upload
    Initial upload of component repo
    [12rnd_Rival_Magazine.STEP, 12v_35mm_Solenoid_OFD.STEP, 130_Nerf_Motor_OFD.STEP, 14mm_led_power_switch_OFD.STEP, 1500_2s_100x35x15_OFD.STEP, 3s_23x33x75_OFD.STEP, 4s_Graphene_Panther_1300mah_36x35x75_OFD.STEP, 5A_DB2_Microswitch_OFD.STEP]
2022-08-30 Add files via upload
    increased lift pusher wheels so you don't have to bend the switch arm to get the pusher to stop on certain live and dead center applications
    [Pusher_Wheel++_V1.STEP, Pusher_Wheel+_V1.STEP]
2022-08-30 Add files via upload
    increased lift pusher wheels to try and eliminate having to bend the pusher switch arm on certain applications
    [Pusher_Wheel++_V1.STL, Pusher_Wheel+_V1.STL]
2022-08-31 Add files via upload
    volt meter blanking plate
    [Volt_Meter_BLANKING_PLATE.STL]
2023-12-21 Add files via upload
    Experimental Spartan Flycore - wheels by Tinkershot/Spitfire Products
    [OFD_FLYCORE_ANGLED_SPARTAN_23.5MM_V2.STL]
2024-01-23 Add Traceur 25mm-spacing cores
    [OFD_FLYCORE_ANGLED_TRACEUR_25MM_V1.step, OFD_FLYCORE_ANGLED_TRACEUR_25MM_V1.stl]
